toothbrushtoo/the-clip/hardware/README.md

# Hardware

## Parts (v1)

| Part | Spec | Source | Price (Cad) | Status |
|---|---|---|---|---|
| Board | Seeed  XIAO nRF52840 Sense Plus | RobotShop | 23.34 +9.96 ship | ordered Oct 30, shipped |
| Battery | 502030 LiPo 3.7 V 250 mAh, JST | Amazon | 16.99 | ordered Oct 30, ordered Oct 29, ~nov 6 |
| Switch | SS12D00 slide, 3 mm knob, 50pk | Amazon | 7.89 | ordered Oct 29, Oct 31 |
stuff for box hasnt been ordered yet.

## Sketches

See `sketches/`, one file per version.

- v0.1 (Oct 29): first layout, 35 x 25 x 13 mm
- v0.2 (Oct 30): 37 mm long for the battery, 10 mm groove, flush magnets 1.5kg pull force.
-
