toothbrushtoo/the-clip/demo/README.md

Videos, test numbers and material for the final demo.
