toothbrushtoo/the-clip/firmware/README.md

Code that runs on the clip (Arduino, XIAO nRF52840 Sense).
