toothbrushtoo/the-clip/hardware/data/phyphox/plots/curl_normal_7.png

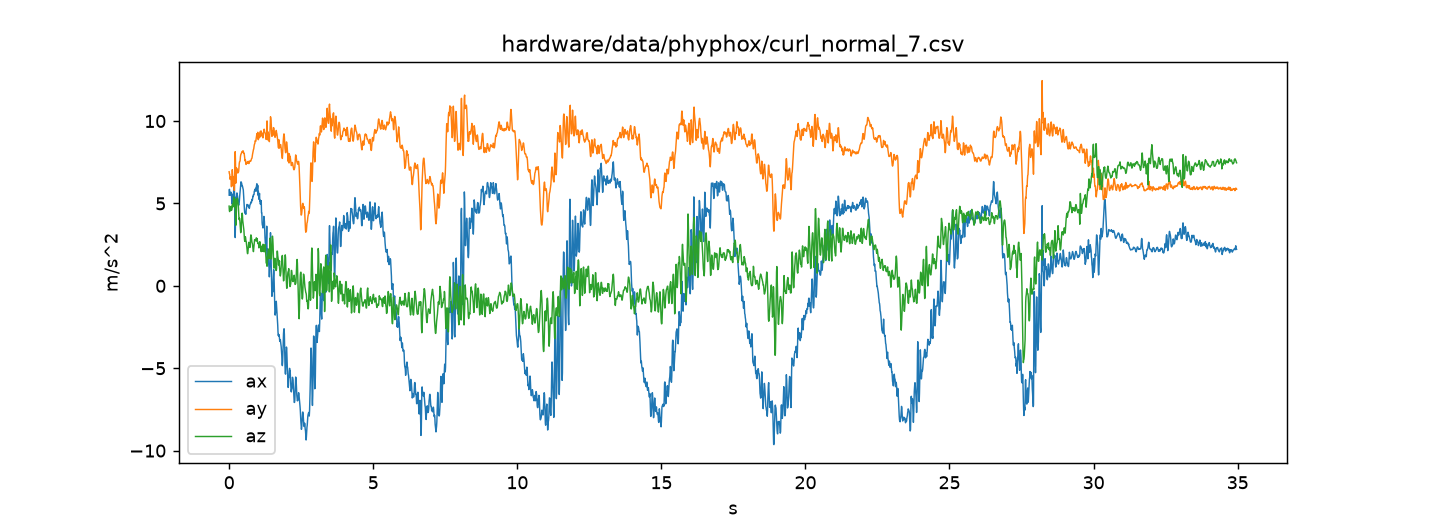
hardware/data/phyphox/plots/curl_normal_7.png
