toothbrushtoo/the-clip/hardware/data/phyphox/plots/junk_walk.png

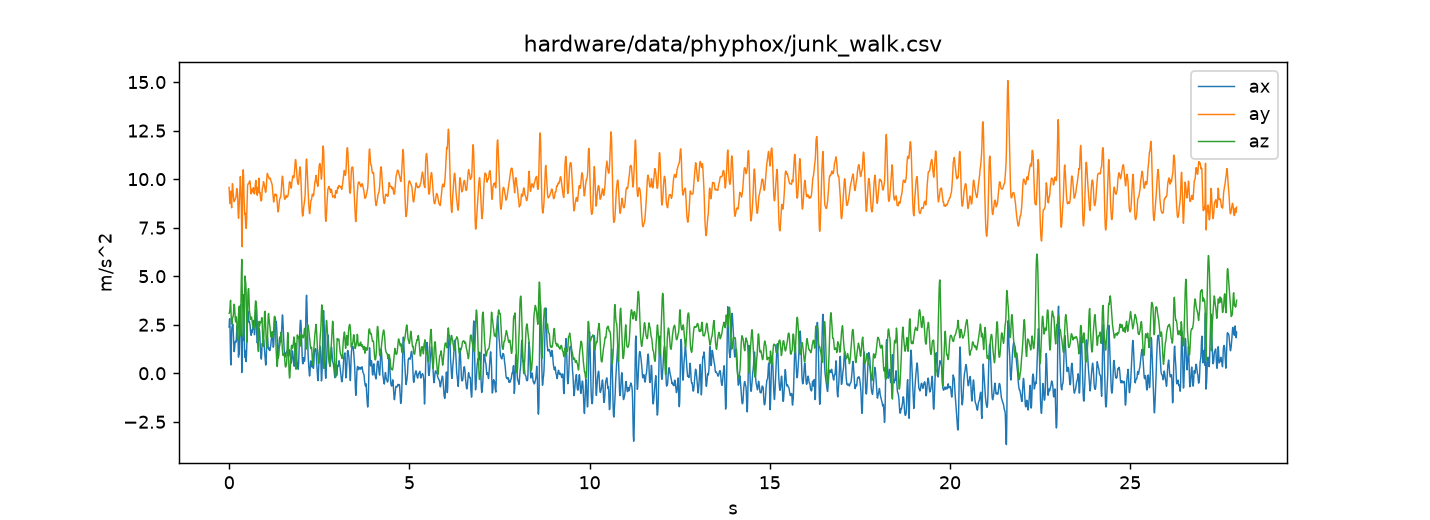
hardware/data/phyphox/plots/junk_walk.png
