toothbrushtoo/the-clip/hardware/data/phyphox/plots/sideways_10.png

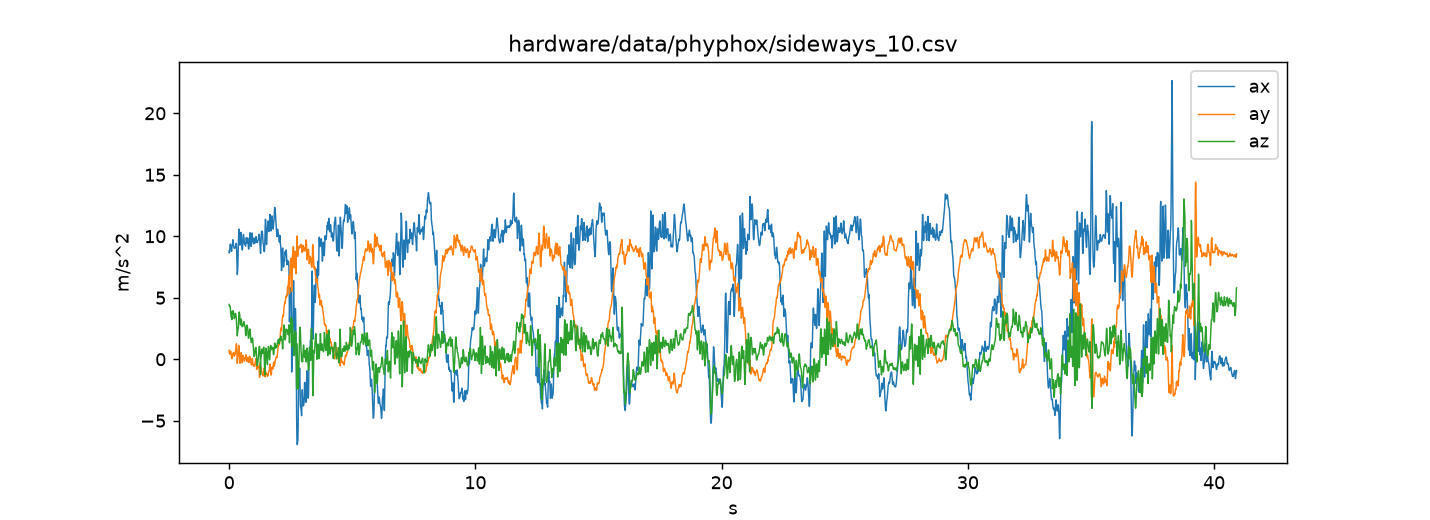
hardware/data/phyphox/plots/sideways_10.png
