toothbrushtoo/the-clip/hardware/data/phyphox/rigside1.jpeg

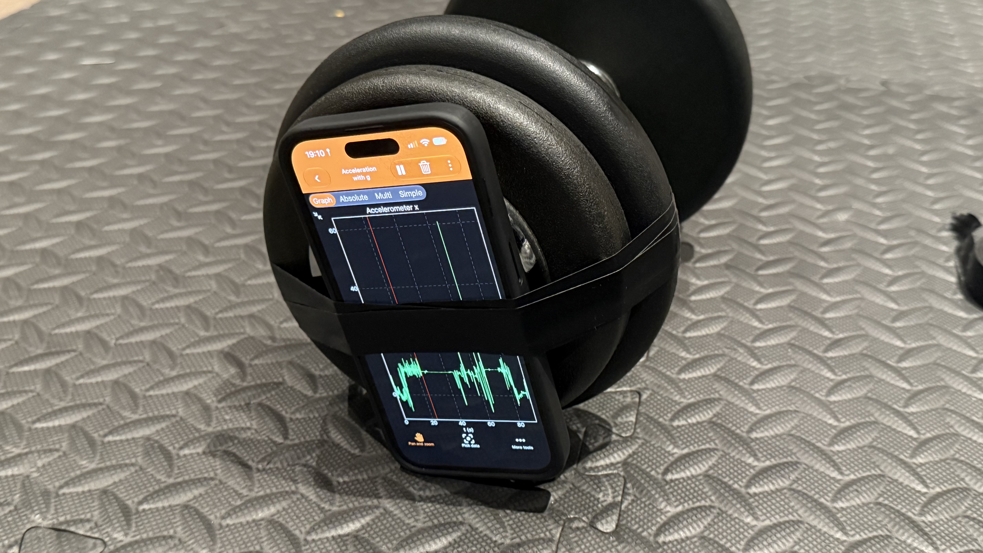
hardware/data/phyphox/rigside1.jpeg
