toothbrushtoo/the-clip/hardware/data/phyphox/rigside2.jpeg

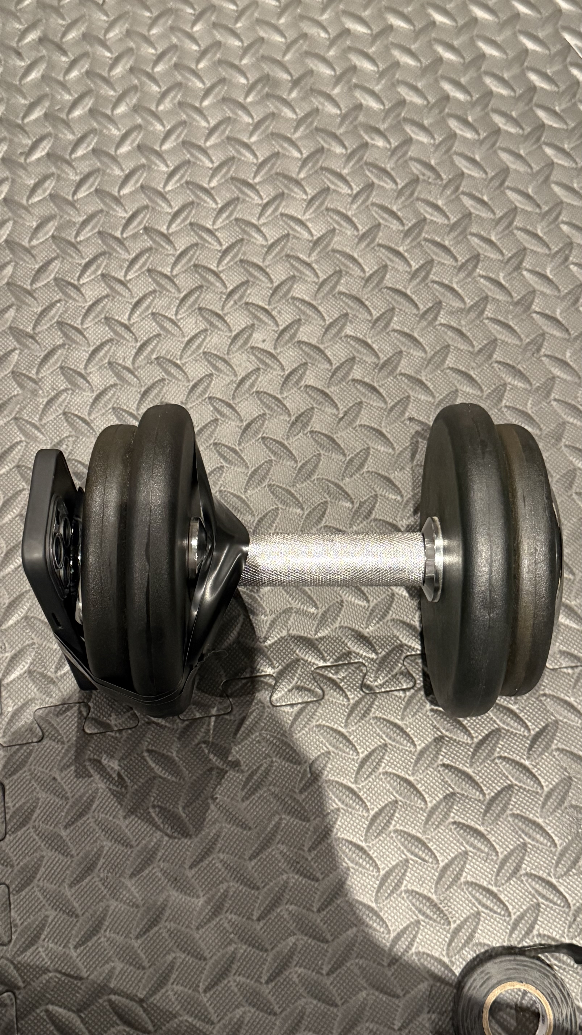
hardware/data/phyphox/rigside2.jpeg
