toothbrushtoo/the-clip/hardware/reciepts/board-reciept.png

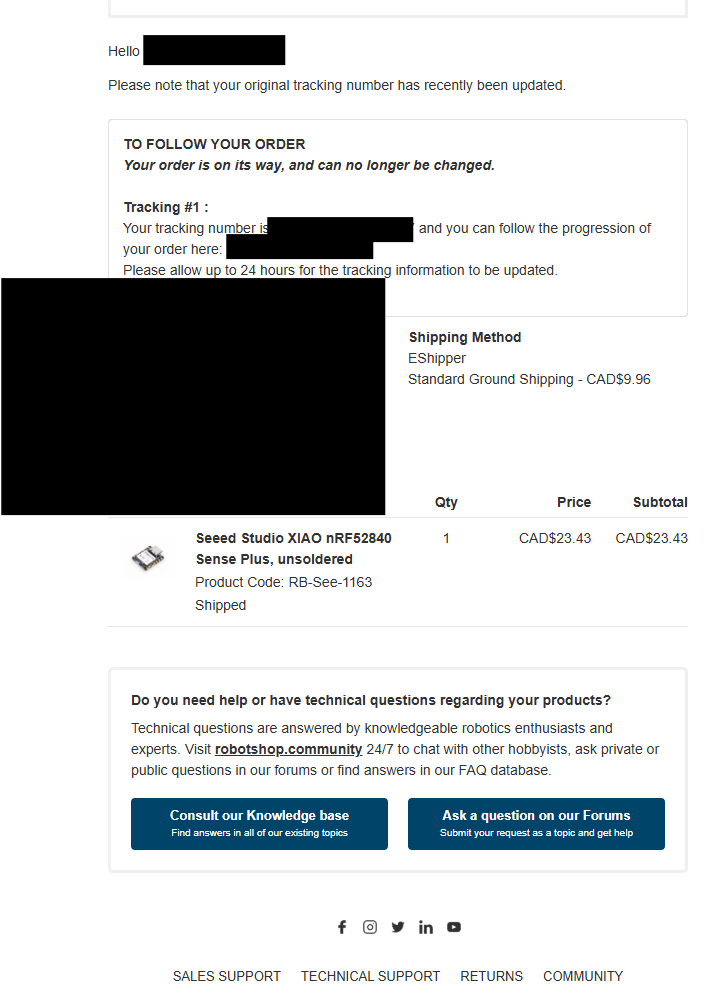
hardware/reciepts/board-reciept.png
