toothbrushtoo/the-clip/hardware/sketches/v0.1-oct29.webp

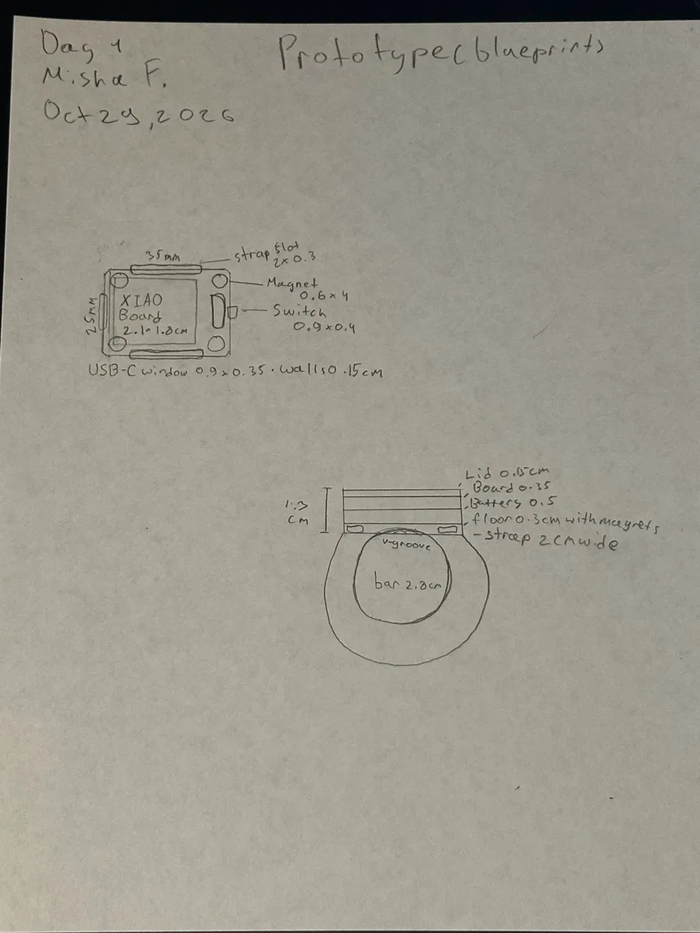
hardware/sketches/v0.1-oct29.webp
