toothbrushtoo/the-clip/hardware/reciepts/amazon purchases 2026-10-29 182430.png

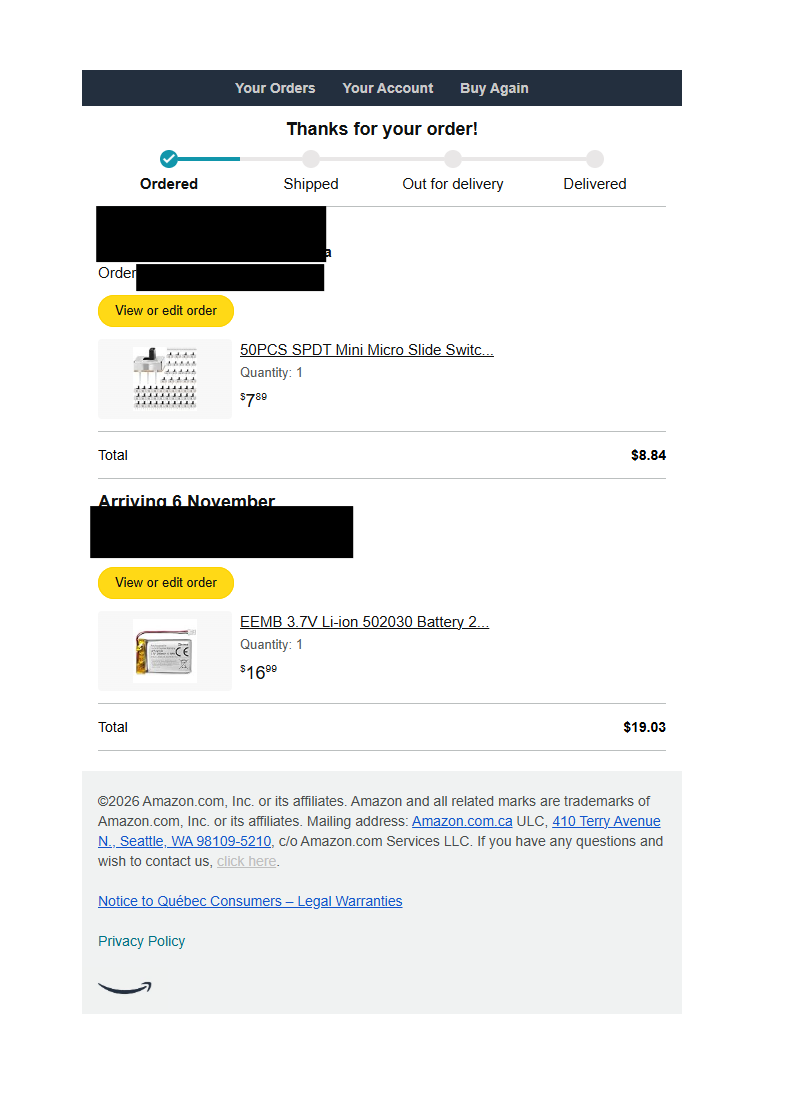
hardware/reciepts/amazon purchases 2026-10-29 182430.png
