toothbrushtoo/the-clip/hardware/data/phyphox/curl_test_3.csv

Time (s) | Acceleration x (m/s^2) | Acceleration y (m/s^2) | Acceleration z (m/s^2) | Absolute acceleration (m/s^2)
0.0 | 7.289391632 | -6.446195068 | 0.2582130432 | 9.734235214
0.010043000000003133 | 7.291337585 | -6.483168182 | 0.2570155334 | 9.760180862
0.02008599999999916 | 7.311695251 | -6.52553009 | 0.2415975952 | 9.803152544
0.030129000000002293 | 7.337142334 | -6.555767212 | 0.2002835083 | 9.841333997
0.04017199999999832 | 7.370822296 | -6.59932663 | 0.1898052979 | 9.895259438
0.05021599999999893 | 7.403753815 | -6.612948303 | 0.1895059204 | 9.92887548
0.06025900000000206 | 7.363487549 | -6.594237213 | 0.2236349487 | 9.887109077
0.07030199999999809 | 7.288194122 | -6.539151764 | 0.237406311 | 9.794623071
0.08034500000000122 | 7.234306183 | -6.524631958 | 0.2424957275 | 9.744989087
0.09038799999999725 | 7.271428986 | -6.548432465 | 0.2514770508 | 9.788712272
0.10043100000000038 | 7.289092255 | -6.583010559 | 0.2327659607 | 9.824513927
0.11047400000000351 | 7.311695251 | -6.623725891 | 0.2233355713 | 9.868359079
0.12051799999999702 | 7.302115173 | -6.612948303 | 0.2215393066 | 9.85398655
0.13056100000000015 | 7.273374939 | -6.609056396 | 0.2098635864 | 9.829834799
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
