toothbrushtoo/the-clip/hardware/data/phyphox/plots/curl_test_3.png

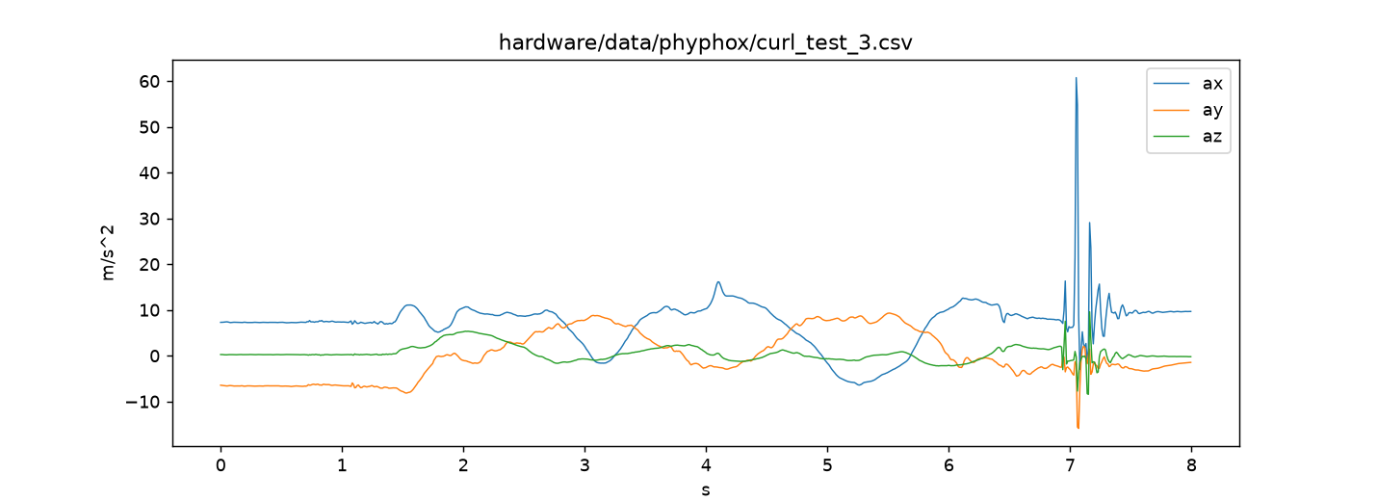
hardware/data/phyphox/plots/curl_test_3.png
