toothbrushtoo/the-clip/(commit log)

2026-10-30 Add v0.1 enclosure sketch
2026-10-30 Create imu_stream.ino test scripts
2026-10-30 Move log_imu.py to tools, rename sketch, fix size to 13 mm
2026-10-31 Rename to curl_normal_7, add remaining plots
    [curl_normal_7.csv]
2026-11-01 Record finished sets with reps, duration and start time
    Add WorkoutSet model, track set start in ClipSession, and show a
    history list of completed sets in ContentView.
    Claude-Session: https://claude.ai/code/session_017gVCXxzVQLL63wSixkY6Wo
2026-11-04 Remove duplicate WorkoutRunView (case clash), keep typed version
    Claude-Session: https://claude.ai/code/session_017gVCXy1MkSxFQMD9WN7o8W
2026-11-05 AirPods-style connection sheet driven by real BLE state
    - ConnectionSheetView.swift: card that springs up from the bottom with a drawn
    XIAO board; searching / found / connecting / connected / failed phases, rings,
    blue double-blink, self-drawing checkmark, battery + signal, shake on failure,
    haptics, Reduce Motion support.
    - ClipBLE: real found and failed states, connect waits for the user while the
    sheet is up, scan/connect timeouts, connected only once the command
    characteristic is ready. Automatic flow elsewhere is unchanged.
    - SessionView: Connect on the Workout tab presents the sheet for the Clip source.
    Claude-Session: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
2026-11-05 Find My Clip: Find My-style finder with two-sided signal, haptics and flash
    Firmware: new rssi characteristic (0x0005) the clip streams at 5 Hz while the
    app subscribes; find command 0x03 now strobes all LEDs white until 0x04 or 60 s;
    TX power 8 dBm for range; clip-side RSSI monitoring on connect.
    App: FindClipView, a dark Find My-style screen. Signal from both ends of the
    link is offset-matched, pooled over 2 s, median-filtered and smoothed, then
    mapped to Far / Near / Here and an approximate distance using a calibratable
    1 m reference. Pulse rings and haptics speed up as you get closer, a success
    haptic and checkmark when you're there, Flash Clip toggles the LEDs, and a
    calibration sheet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
2026-11-05 Rep engine v0.4: rotation + motion + velocity detectors, teachable profiles; Python reference and Swift port with a CI cross-check; all 23 phyphox recordings
    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
    [bent_row_10.csv, curl_fast_10.csv, curl_pause_7.csv, curl_rigid_10.csv, curl_slow_4.csv, goblet_squat_10.csv, hammer_curl_10.csv, junk_carry.csv]
2026-11-05 Teach-by-doing exercises, workouts with sets x reps x weight, auto-advance with a ding
    - RepEngine runs on the phone from the clip's raw motion stream (new characteristic 0x0006)
    or the phone's own sensors; the clip's on-board count is the fallback.
    - TeachExerciseView: name it, do 20 reps, confirm the count, the learner picks the detector
    and threshold that reproduce it; saved per exercise and used in every workout.
    - Exercise library with presets (some with profiles estimated from our recordings).
    - Workouts now hold weight, sets and reps per exercise; the run screen ends a set on target,
    dings, rests, and moves to the next exercise; finishes with a summary.
    - Firmware: burst IMU rea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
2026-11-05 Rotation detector = tilt from rest (gyro-tracked gravity, accel-corrected): same count whichever way the clip is mounted; synthetic gyro fixtures in the CI check
    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
    [synth_curl_20.csv, synth_curl_flipped_20.csv, synth_curl_holdtop_20.csv, synth_curl_slow_20.csv]
2026-11-07 Sleep when idle, wake on motion
    Firmware: System OFF after 5 min still or 20 min without a phone (never while connected, in a
    set or on USB); the IMU stays in 26 Hz low-power wake-up mode and wakes the clip on > 0.125 g;
    USB also wakes it. Small wobbles are ignored. App: Settings > Put clip to sleep (0x08).
    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
    [clip.ino]
2026-11-08 Fix sleep: slope-filter wake (no false trigger on arming), verify INT1 quiet before sleeping, 30 s false-wake timeout, no retry loop, one short blink; serial 's' to test sleep on USB
    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
    [clip.ino]
